enzogomes2006/esp32-deteccao-erros-telemetria/revisoes/corpo64/dados/README.md

# Série física CORPO64 - 19/10/2026

Sete pastas, uma por condição, cada uma com seis arquivos originais do coletor. Não alterar contagens nem logs manualmente. Os nomes conservam o horário local e a configuração da coleta. A série começa na sequência zero e tem mil posições por rodada.

Os CSVs foram cruzados byte a byte com os logs brutos e com o injetor. Os dados antigos de payload ficam em dados/ na raiz. Os controles curtos estão em ../triagem/ e não entram nas contagens destas sete rodadas.

Consulte ../PROVENIENCIA_COLETAS.json, ../validacao/VALIDACAO_FISICA.json e ../../../Relatorio_Final_ESP32.md. Os metadados preservam as portas observadas e os campos de verificação de firmware, sem afirmar leitura de flash.
