enzogomes2006/esp32-deteccao-erros-telemetria/LEIA_PRIMEIRO.md

# Começar pela série CORPO64

Os ensaios físicos de 19/10/2026 estão consolidados. Abra README.md para os resultados e Relatorio_Final_ESP32.pdf para o relatório atual.

Para repetir a bancada, use somente firmware e coletor em revisoes/corpo64/. O roteiro é GUIA_DEMONSTRACAO.md. As pastas firmware/, coletor/ e dados/ na raiz são da série anterior.

As pendências humanas de entrega estão em PROXIMOS_PASSOS.md. A apresentação, defesa e predição ao vivo não foram declaradas realizadas.
