enzogomes2006/esp32-deteccao-erros-telemetria/PROXIMOS_PASSOS.md

# Estado da conclusão e entrega

Atualização: 19/10/2026, série CORPO64.

## Concluído com registros

- [x] Inicialização do RX CORPO64 v1.0 e RUÍDO CORPO64 v2.0 observada durante a gravação.
- [x] Sete testes curtos de dez quadros e controles complementares sem ruído.
- [x] Sete rodadas de mil quadros e 56.000 amostras do injetor, preservadas com CSVs, logs e metadados.
- [x] Recalcular contagens, resíduos, máscaras e tempos; cruzar decisão anterior à referência e bytes do injetor.
- [x] Identificar dois erros não detectados naturais do SUM8, sequências 415 e 553.
- [x] Registrar cálculo TX, verificação RX, intervalos e controle de recuperação após pausa de recepção.
- [x] Atualizar relatório, gráficos, protocolo, roteiro de apresentação e documentos de entrada do repositório.

Os arquivos de dados e metadados originais não foram corrigidos manualmente. A revisão dos registros não certifica montagem nem calibração elétrica. Os hashes dos fontes não são leitura do firmware instalado nas placas.

## Ainda precisa ser feito pelo integrante

- [ ] Ler o relatório atualizado e conferir a identificação, os requisitos originais do professor e a declaração de assistência de IA.
- [ ] Ensaiar a explicação de TX, RX e RUÍDO, incluindo LEN inválido, sequência e auditoria posterior.
- [ ] Preparar cada integrante para prever os contadores de dez quadros e justificar a previsão antes de executar o cenário escolhido pelo professor.
- [ ] Conferir acesso ao GitHub público e levar uma cópia local do repositório/PDF para a aula.
- [ ] Entregar pelo canal indicado e realizar a demonstração/defesa presencial.

Use APRESENTACAO_20_MIN.md e GUIA_DEMONSTRACAO.md. A presença de dados e documentos não substitui a avaliação presencial nem declara conformidade com regras de autoria que não foram fornecidas integralmente.
