enzogomes2006/esp32-deteccao-erros-telemetria/latex/LEIA_LATEX.md

# Fonte LaTeX atual

main.tex contém o mesmo conteúdo do relatório Markdown CORPO64 e é regenerado por scripts/gerar_pdf.py. Compile com pdfLaTeX na pasta latex/. Os gráficos PDF ficam em revisoes/corpo64/graficos/.

O PDF publicado na raiz é diagramado com ReportLab a partir do Markdown pelo mesmo script. A compilação LaTeX é uma alternativa de layout; não há promessa de paginação idêntica. A fonte antiga foi preservada em historico/payload_2026-10-17/latex/.
