enzogomes2006/esp32-deteccao-erros-telemetria/pdfs_por_etapa/Parte_6_Validacao_do_RX_Completo_ESP32.pdf

TELEMETRIA ESP32 | EVIDÊNCIAS DO RX COMPLETO | 17/10/2026 | 1 / 5
PARTE 6 | VALIDAÇÃO DO RX COMPLETO v0.2

# Quatro ensaios curtos na bancada

Registro das capturas recebidas nesta etapa. Dez quadros por ensaio, sequência de 0 a 9, RX completo na placa identificada como COM6.

Ensaio | OK | CORROMPIDO | PERDIDO | NÃO DETECTADO | Verificação média RX (µs)
CRC8 sem ruído | 10 | 0 | 0 | 0 | 3,400
SUM8 / padrão do modo 4 | 0 | 0 | 0 | 10 | 1,000
CRC8 / padrão do modo 4 | 0 | 10 | 0 | 0 | 3,000
CRC8 / pausa da UART | 7 | 0 | 3 | 0 | 3,143

Resultado desta etapa. Os quatro ensaios apresentaram os comportamentos esperados. A rodada de recuperação tem rodada_valida=SIM confirmado na captura complementar. Nos outros três ensaios, os contadores de auditoria visíveis são zero, mas o final da linha de validação está cortado; seu indicador final não foi conferido.

O que foi observado: recepção limpa com 10 OK; alterações aceitas pelo SUM8 e depois identificadas pela auditoria; alterações descartadas pelo CRC8 antes da cópia; três perdas durante a pausa e retomada da recepção no quadro 5.

Alcance: estes testes exercitam as quatro classificações do RX completo. São ensaios complementares de dez quadros, separados das tabelas de 1000 quadros da Parte
1. As duas rodadas do modo 4 usam payloads diferentes; não representam reprodução do mesmo fluxo de bytes.

Premissa do firmware: o injetor tem como alvo o payload. O receptor usa a sequência recebida também em descartes, sob a premissa de cabeçalho sem alteração. As capturas não demonstram robustez genérica contra corrupção do cabeçalho.

Referência da implementação: rx_completo/rx_completo.ino, v0.2. Os arquivos anteriores e os resultados das Partes 1 a 5 foram preservados.

SHA256 do RX completo: aa1dec0e72c4eb6e4c8cdcc0e94e694f1ba34cb85912151970514fde71d017c3

Pendências externas a esta etapa: consolidar CSVs brutos, revisar o pareamento das condições de ruído das rodadas de 1000, atualizar a especificação e o pacote oficial para a versão escolhida, organizar repositório e demonstração. Esta validação não encerra todo o trabalho.

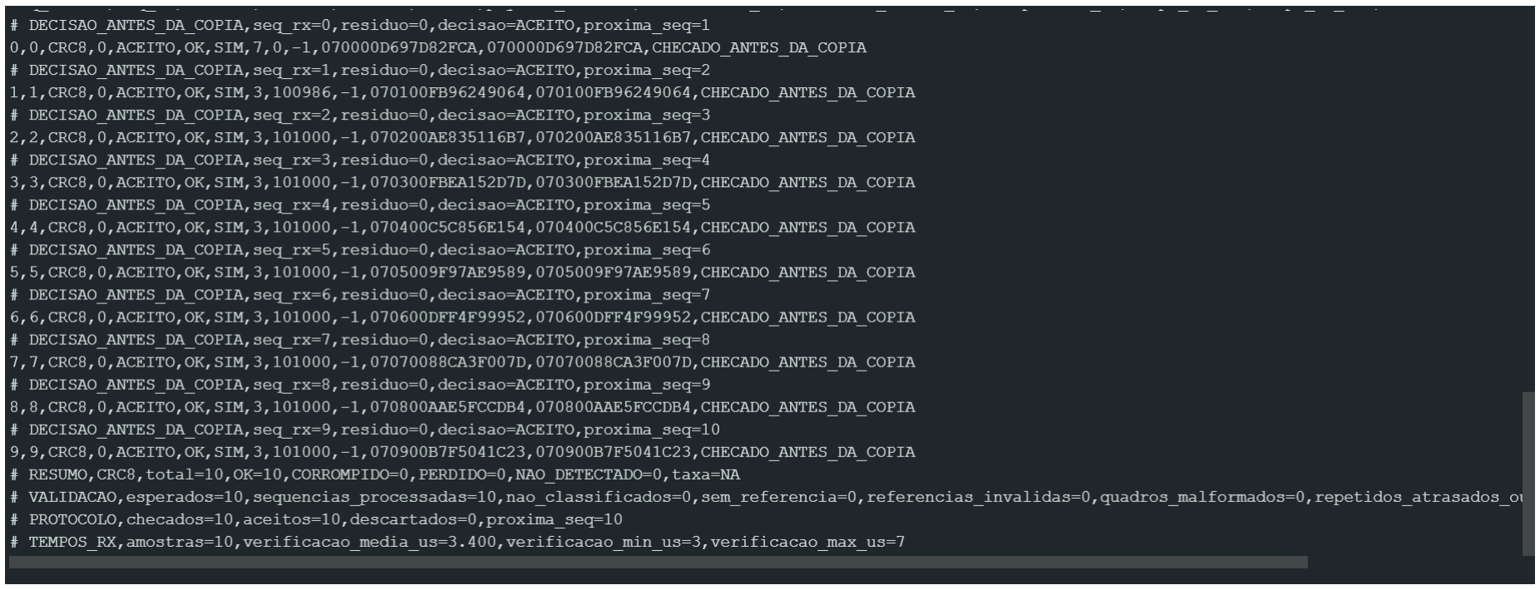
[picture p8: figure]

TELEMETRIA ESP32 | EVIDÊNCIAS DO RX COMPLETO | 17/10/2026 | 2 / 5

# 1. Controle CRC8 sem ruído

Comandos solicitados: RUÍDO 0; RX c, depois d; TX c, depois t. Cada comando enviado separadamente.

Fonte: captura enviada pelo usuário, codex-clipboard-09538eff-b445-47c5-9f80-a528c72ded37.png.
Resumo observado: total=10, OK=10, CORROMPIDO=0, PERDIDO=0, NAO_DETECTADO=0. O protocolo informa 10 checados, 10 aceitos, zero descartes e próxima sequência 10. Cada decisão visível precede a auditoria da cópia.

Tempo de verificação: 10 amostras; média 3,400 µs, mínimo 3 µs e máximo 7 µs. É a duração de checagem registrada pelo firmware, não a latência completa do enlace.

Validação visível: zero não classificados, sem referência, referências inválidas e quadros malformados. O final da linha, incluindo o indicador global, ficou fora da imagem.

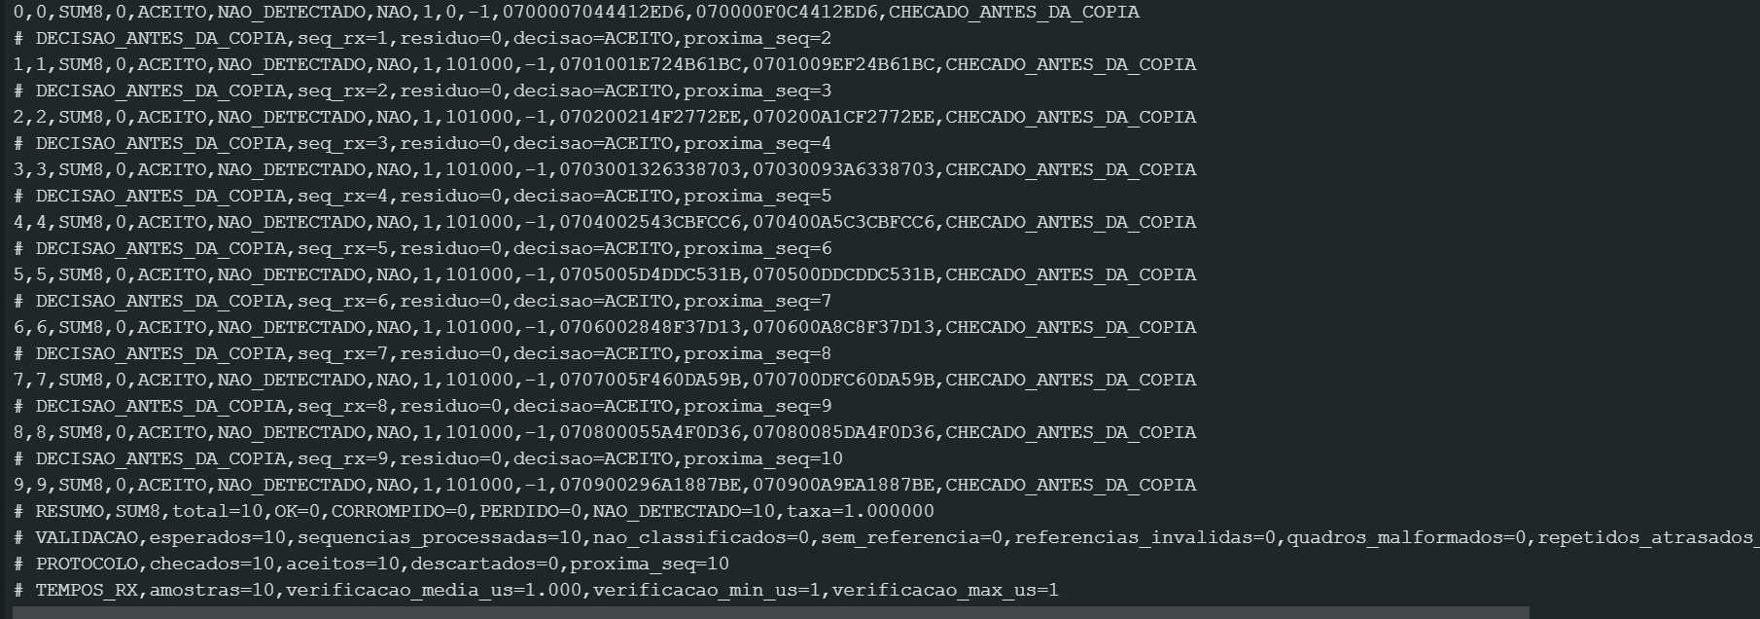
[picture p9: figure]

TELEMETRIA ESP32 | EVIDÊNCIAS DO RX COMPLETO | 17/10/2026 | 3 / 5

# 2. SUM8 aceitou o payload alterado

Comandos solicitados: RUÍDO 4; RX s, depois d; TX s, depois t. O padrão observado apaga o bit 7 de dois bytes do payload.

Fonte: captura enviada pelo usuário, codex-clipboard-51f1190f-db2d-4dd5-851a-5d915f8862e7.png.
Resumo observado: total=10, OK=0, CORROMPIDO=0, PERDIDO=0, NAO_DETECTADO=10. O enlace aceitou os dez; a auditoria posterior encontrou payloads diferentes da referência. A taxa impressa é 1,000000: 100% entre os dez quadros com erro deste ensaio específico.

Exemplo do quadro 0: original 07 00 00 F0 C4 41 2E D6; recebido 07 00 00 70 44 41 2E D6. F0 virou 70 e C4 virou 44: redução de 128 + 128 = 256. As somas incluindo CHK são 768 e 512; ambas têm resto zero módulo 256. Por isso o SUM8 aceitou o quadro alterado.

Tempo de verificação: 10 amostras, média/mínimo/máximo de 1 µs. Contadores visíveis de auditoria zerados; indicador final de validade cortado. A captura do RX comprova a alteração dos bytes, mas não substitui o log do injetor para documentar sua temporização.

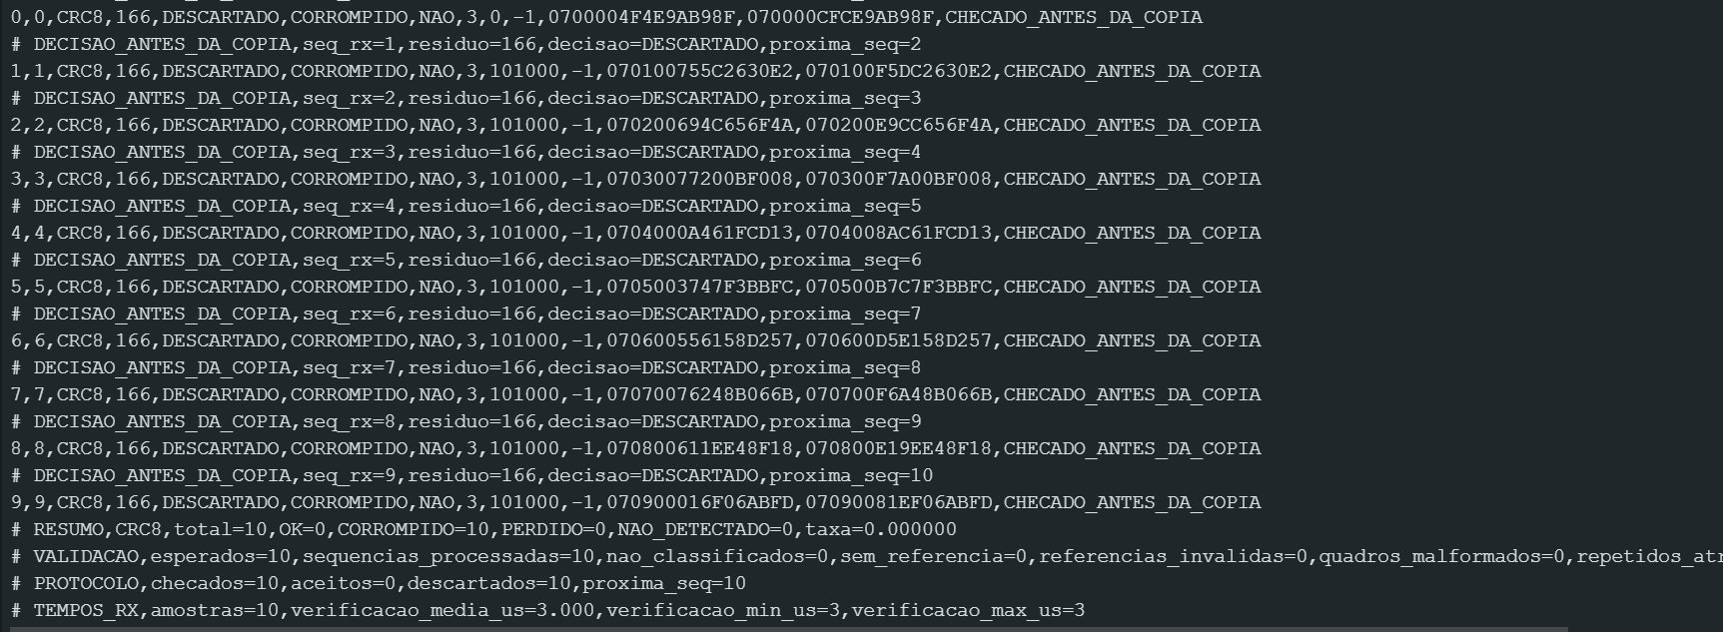
[picture p10: figure]

TELEMETRIA ESP32 | EVIDÊNCIAS DO RX COMPLETO | 17/10/2026 | 4 / 5

# 3. CRC8 descartou o mesmo padrão de erro

Comandos solicitados: manter RUÍDO 4; RX c, depois d; TX c, depois t. O padrão é o mesmo; os bytes de dados desta rodada são outros.

Fonte: captura enviada pelo usuário, codex-clipboard-03e2bd2e-41fe-4251-af52-fde8f52488ac.png.
Resumo observado: total=10, OK=0, CORROMPIDO=10, PERDIDO=0, NAO_DETECTADO=0. O protocolo informa zero aceitos, dez descartados e próxima sequência
10. Os descartes não foram somados novamente como perdas.

Exemplo do quadro 0: original 07 00 00 CF CE 9A B9 8F; recebido 07 00 00 4F 4E 9A B9 8F. Os dois bytes diferem por 0x80. O original tem resíduo CRC zero; o recebido tem resíduo 166 (0xA6), também registrado nas decisões anteriores à cópia. O recálculo local dos bytes transcritos confirma esses valores.

Tempo de verificação: 10 amostras, média/mínimo/máximo de 3 µs. Contadores visíveis de auditoria zerados; indicador final de validade cortado. Zero não detectados nestes dez quadros não é uma garantia para todo padrão possível de erro.

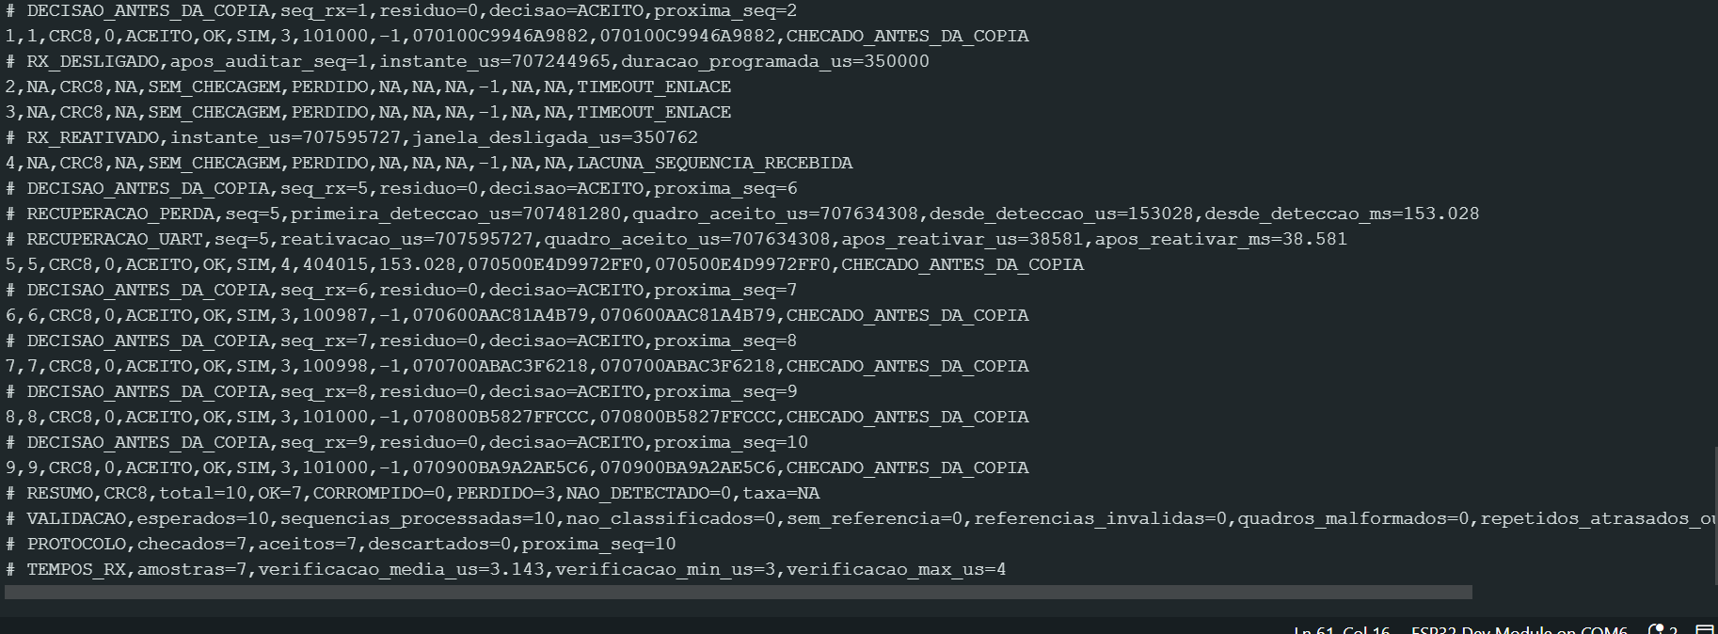
[picture p11: figure]

TELEMETRIA ESP32 | EVIDÊNCIAS DO RX COMPLETO | 17/10/2026 | 5 / 5

# 4. Perda induzida e recuperação

Comandos solicitados: RUÍDO 0; RX c, depois a; TX c, depois t. O próprio RX pausa a UART após checar e auditar a sequência 1.

Fonte: captura enviada pelo usuário, codex-clipboard-05f11e81-e1f4-49f4-b1b0-d75d64303fdd.png.

Resumo | Janela da UART desligada | Primeira perda até ACEITO | Reativação até ACEITO
7 OK; 3 PERDIDO (2, 3 e 4) | 350,762 ms | 153,028 ms | 38,581 ms

As sequências 2 e 3 foram marcadas por TIMEOUT_ENLACE; a 4, por lacuna ao receber a 5. O quadro 5 foi aceito antes da cópia, depois auditado como OK, e a recepção seguiu até o 9. Instantes em µs: UART desligada 707244965; primeira perda 707481280; UART reativada 707595727; próximo ACEITO 707634308.

Confirmação complementar: rodada_valida=SIM, repetidos_atrasados_ou_fora=0. Fonte: captura codex-clipboard-a7fccf98-29ba-4e8a-97a6-9913ed3686b8.png. As duas capturas mostram os mesmos instantes de recuperação.

Tempos RX: sete amostras, média 3,143 µs, mínimo 3 µs e máximo 4 µs. A perda foi provocada por pausa de software na UART, não por ruído elétrico. Os tempos deste RX completo não substituem as medidas do RX separado da Parte 4.
