enzogomes2006/esp32-deteccao-erros-telemetria/dados/20261019_095219_782_SUM8_modo2_1000/rx.csv

evento_id | seq_experimento | seq_rx | seq_referencia | seq_enlace_esperada | seq_enlace_proxima | tecnica | len_rx | residuo | decisao | status | payload_confere | cabecalho_diverge | entregue_aplicacao | verificacao_us | intervalo_inicio_us | recuperacao_ms | corpo_rx_hex | corpo_tx_hex | motivo | decisao_us | referencia_us
1 | 0 | 0 | 0 | 0 | 0 | SUM8 | 7 | 192 | DESCARTADO | CORROMPIDO | NAO | NAO | NAO | 1 | 0 | -1 | 070000EBFC1D288D | 070000EBFC5D288D | CHECADO_ANTES_DA_COPIA | 667833318 | 667847401
2 | 1 | 1 | 1 | 0 | 2 | SUM8 | 7 | 0 | ACEITO | OK | SIM | NAO | SIM | 1 | 101001 | -1 | 07010097D3AD4B96 | 07010097D3AD4B96 | CHECADO_ANTES_DA_COPIA | 667934318 | 667948401
3 | 2 | 2 | 2 | 2 | 2 | SUM8 | 7 | 252 | DESCARTADO | CORROMPIDO | NAO | NAO | NAO | 1 | 101000 | -1 | 070200EB9FBE2A81 | 070200EB9FBE2E81 | CHECADO_ANTES_DA_COPIA | 668035318 | 668049401
4 | 3 | 3 | 3 | 2 | 2 | SUM8 | 7 | 254 | DESCARTADO | CORROMPIDO | NAO | NAO | NAO | 1 | 101000 | -1 | 070300E3C19C2193 | 070300E3C19E2193 | CHECADO_ANTES_DA_COPIA | 668136318 | 668150401
5 | 4 | 0 | 4 | 2 | 2 | SUM8 | 7 | 252 | DESCARTADO | CORROMPIDO | SIM | SIM | NAO | 1 | 101000 | -1 | 070000C4961E205D | 070400C4961E205D | CHECADO_ANTES_DA_COPIA | 668237318 | 668251401
6 | 5 | 5 | 5 | 2 | 2 | SUM8 | 7 | 248 | DESCARTADO | CORROMPIDO | NAO | NAO | NAO | 1 | 101000 | -1 | 070500C1B4210056 | 070500C1B4290056 | CHECADO_ANTES_DA_COPIA | 668338318 | 668352401
7 | 6 | 6 | 6 | 2 | 2 | SUM8 | 3 | NA | SEM_CHECAGEM | PERDIDO | NAO | SIM | NAO | NA | 101000 | -1 | 030600A89368B798 | 070600A99368B798 | LEN_INVALIDO | 668439316 | 668453401
8 | 7 | 7 | 7 | 2 | 8 | SUM8 | 7 | 0 | ACEITO | OK | SIM | NAO | SIM | 1 | 101000 | -1 | 0707008EAD7F98A0 | 0707008EAD7F98A0 | CHECADO_ANTES_DA_COPIA | 668540318 | 668554401
9 | 8 | 8 | 8 | 8 | 9 | SUM8 | 7 | 0 | ACEITO | OK | SIM | NAO | SIM | 1 | 101000 | -1 | 07080084C2061392 | 07080084C2061392 | CHECADO_ANTES_DA_COPIA | 668641318 | 668655401
10 | 9 | 9 | 9 | 9 | 9 | SUM8 | 7 | 254 | DESCARTADO | CORROMPIDO | NAO | NAO | NAO | 1 | 101000 | -1 | 070900CD90BE458E | 070900CD90BE478E | CHECADO_ANTES_DA_COPIA | 668742318 | 668756401
11 | 10 | 10 | 10 | 9 | 9 | SUM8 | 7 | 254 | DESCARTADO | CORROMPIDO | NAO | NAO | NAO | 1 | 101000 | -1 | 070A00818D127C51 | 070A00838D127C51 | CHECADO_ANTES_DA_COPIA | 668843318 | 668857401
12 | 11 | 11 | 11 | 9 | 9 | SUM8 | 7 | 128 | DESCARTADO | CORROMPIDO | NAO | NAO | NAO | 1 | 101000 | -1 | 070B00EAD4304040 | 070B00EAD4B04040 | CHECADO_ANTES_DA_COPIA | 668944318 | 668958401
13 | 12 | 12 | 12 | 9 | 13 | SUM8 | 7 | 0 | ACEITO | OK | SIM | NAO | SIM | 1 | 101000 | -1 | 070C00DDB3BC4160 | 070C00DDB3BC4160 | CHECADO_ANTES_DA_COPIA | 669045318 | 669059401
14 | 13 | 13 | 13 | 13 | 13 | SUM8 | 5 | NA | SEM_CHECAGEM | PERDIDO | SIM | SIM | NAO | NA | 101000 | -1 | 050D00CFA431DD6B | 070D00CFA431DD6B | LEN_INVALIDO | 669146316 | 669160401
15 | 14 | 14 | 14 | 13 | 13 | SUM8 | 7 | 255 | DESCARTADO | CORROMPIDO | NAO | NAO | NAO | 1 | 101000 | -1 | 070E0096EF9C5376 | 070E0097EF9C5376 | CHECADO_ANTES_DA_COPIA | 669247318 | 669261401
16 | 15 | 15 | 15 | 13 | 16 | SUM8 | 7 | 0 | ACEITO | OK | SIM | NAO | SIM | 1 | 101000 | -1 | 070F00DE93DCF4A9 | 070F00DE93DCF4A9 | CHECADO_ANTES_DA_COPIA | 669348318 | 669362401
17 | 16 | 16 | 16 | 16 | 16 | SUM8 | 7 | 255 | DESCARTADO | CORROMPIDO | NAO | NAO | NAO | 1 | 101000 | -1 | 07100095BC15F58D | 07100095BD15F58D | CHECADO_ANTES_DA_COPIA | 669449318 | 669463401
18 | 17 | 17 | 17 | 16 | 16 | SUM8 | 7 | 160 | DESCARTADO | CORROMPIDO | SIM | NAO | NAO | 1 | 101000 | -1 | 07110085F7DAA092 | 07110085F7DAA0F2 | CHECADO_ANTES_DA_COPIA | 669550318 | 669564401
19 | 18 | 18 | 18 | 16 | 16 | SUM8 | 7 | 240 | DESCARTADO | CORROMPIDO | NAO | NAO | NAO | 1 | 101000 | -1 | 071200AECFCB2C63 | 071200AECFDB2C63 | CHECADO_ANTES_DA_COPIA | 669651318 | 669665401
20 | 19 | 19 | 19 | 16 | 16 | SUM8 | 7 | 128 | DESCARTADO | CORROMPIDO | NAO | NAO | NAO | 1 | 101000 | -1 | 071300CC48F18BD6 | 071300CCC8F18BD6 | CHECADO_ANTES_DA_COPIA | 669752318 | 669766401
21 | 20 | 20 | 20 | 16 | 21 | SUM8 | 7 | 0 | ACEITO | OK | SIM | NAO | SIM | 1 | 101000 | -1 | 071400A286636AF0 | 071400A286636AF0 | CHECADO_ANTES_DA_COPIA | 669853318 | 669867401
22 | 21 | 17 | 21 | 21 | 21 | SUM8 | 7 | 252 | DESCARTADO | CORROMPIDO | SIM | SIM | NAO | 1 | 101000 | -1 | 071100B89B85C448 | 071500B89B85C448 | CHECADO_ANTES_DA_COPIA | 669954318 | 669968401
23 | 22 | 22 | 22 | 21 | 23 | SUM8 | 7 | 0 | ACEITO | OK | SIM | NAO | SIM | 1 | 101000 | -1 | 0716009AB4642E03 | 0716009AB4642E03 | CHECADO_ANTES_DA_COPIA | 670055318 | 670069401
24 | 23 | 23 | 23 | 23 | 23 | SUM8 | 3 | NA | SEM_CHECAGEM | PERDIDO | NAO | SIM | NAO | NA | 101000 | -1 | 031700E2E986711E | 071700E2E986731E | LEN_INVALIDO | 670156316 | 670170401
25 | 24 | 24 | 24 | 23 | 23 | SUM8 | 7 | 248 | DESCARTADO | CORROMPIDO | NAO | NAO | NAO | 1 | 101000 | -1 | 071800E0841D2236 | 071800E0841D2A36 | CHECADO_ANTES_DA_COPIA | 670257318 | 670271401
26 | 25 | 25 | 25 | 23 | 26 | SUM8 | 7 | 0 | ACEITO | OK | SIM | NAO | SIM | 1 | 101000 | -1 | 07190090D28AFEF6 | 07190090D28AFEF6 | CHECADO_ANTES_DA_COPIA | 670358318 | 670372401
27 | 26 | 18 | 26 | 26 | 26 | SUM8 | 7 | 248 | DESCARTADO | CORROMPIDO | SIM | SIM | NAO | 1 | 101000 | -1 | 0712009EFABB107C | 071A009EFABB107C | CHECADO_ANTES_DA_COPIA | 670459318 | 670473401
28 | 27 | 27 | 27 | 26 | 28 | SUM8 | 7 | 0 | ACEITO | OK | SIM | NAO | SIM | 1 | 101000 | -1 | 071B00B2A7752FE1 | 071B00B2A7752FE1 | CHECADO_ANTES_DA_COPIA | 670560318 | 670574401
29 | 28 | 20 | 28 | 28 | 28 | SUM8 | 7 | 248 | DESCARTADO | CORROMPIDO | SIM | SIM | NAO | 1 | 101000 | -1 | 071400C1EED08ED0 | 071C00C1EED08ED0 | CHECADO_ANTES_DA_COPIA | 670661318 | 670675401
30 | 29 | 21 | 29 | 28 | 28 | SUM8 | 7 | 248 | DESCARTADO | CORROMPIDO | SIM | SIM | NAO | 1 | 101000 | -1 | 071500E2F3631B89 | 071D00E2F3631B89 | CHECADO_ANTES_DA_COPIA | 670762318 | 670776401
31 | 30 | 30 | 30 | 28 | 28 | SUM8 | 7 | 128 | DESCARTADO | CORROMPIDO | NAO | NAO | NAO | 1 | 101000 | -1 | 071E008BA51342D6 | 071E008BA513C2D6 | CHECADO_ANTES_DA_COPIA | 670863318 | 670877401
32 | 31 | 31 | 31 | 28 | 28 | SUM8 | 7 | 254 | DESCARTADO | CORROMPIDO | NAO | NAO | NAO | 1 | 101000 | -1 | 071F00E4BB11B771 | 071F00E4BB13B771 | CHECADO_ANTES_DA_COPIA | 670964318 | 670978401
33 | 32 | 32 | 32 | 28 | 33 | SUM8 | 7 | 0 | ACEITO | OK | SIM | NAO | SIM | 1 | 101000 | -1 | 0720008FC75F64C0 | 0720008FC75F64C0 | CHECADO_ANTES_DA_COPIA | 671065318 | 671079401
34 | 33 | 33 | 33 | 33 | 34 | SUM8 | 7 | 0 | ACEITO | OK | SIM | NAO | SIM | 1 | 101000 | -1 | 07210088F37D617F | 07210088F37D617F | CHECADO_ANTES_DA_COPIA | 671166318 | 671180401
35 | 34 | 34 | 34 | 34 | 34 | SUM8 | 3 | NA | SEM_CHECAGEM | PERDIDO | SIM | SIM | NAO | NA | 101000 | -1 | 032200FDDBE12FEF | 072200FDDBE12FEF | LEN_INVALIDO | 671267316 | 671281401
36 | 35 | 35 | 35 | 34 | 34 | SUM8 | 7 | 192 | DESCARTADO | CORROMPIDO | NAO | NAO | NAO | 1 | 101000 | -1 | 072300AC8653BF52 | 072300AC8653FF52 | CHECADO_ANTES_DA_COPIA | 671368318 | 671382401
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
615 | 614 | 610 | 614 | 611 | 611 | SUM8 | 7 | 252 | DESCARTADO | CORROMPIDO | SIM | SIM | NAO | 1 | 101000 | -1 | 076202EBD8CAFA0A | 076602EBD8CAFA0A | CHECADO_ANTES_DA_COPIA | 729848318 | 729861560
616 | 615 | 615 | 615 | 611 | 611 | SUM8 | 7 | 240 | DESCARTADO | CORROMPIDO | NAO | NAO | NAO | 1 | 101000 | -1 | 076702AE9E3E8C6A | 076702AE9E3E9C6A | CHECADO_ANTES_DA_COPIA | 729949318 | 729962560
617 | 616 | 608 | 616 | 611 | 611 | SUM8 | 7 | 248 | DESCARTADO | CORROMPIDO | SIM | SIM | NAO | 1 | 101000 | -1 | 076002BDBC41676E | 076802BDBC41676E | CHECADO_ANTES_DA_COPIA | 730050318 | 730063562
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
