enzogomes2006/esp32-deteccao-erros-telemetria/revisoes/corpo64/triagem/20261019_085335_636_SUM8_modo0_10/rx.csv

evento_id | seq_experimento | seq_rx | seq_referencia | seq_enlace_esperada | seq_enlace_proxima | tecnica | len_rx | residuo | decisao | status | payload_confere | cabecalho_diverge | entregue_aplicacao | verificacao_us | intervalo_inicio_us | recuperacao_ms | corpo_rx_hex | corpo_tx_hex | motivo | decisao_us | referencia_us
1 | 0 | 0 | 0 | 0 | 1 | SUM8 | 7 | 0 | ACEITO | OK | SIM | NAO | SIM | 7 | 0 | -1 | 070000E3C6FDCA89 | 070000E3C6FDCA89 | CHECADO_ANTES_DA_COPIA | 924283356 | 924297395
2 | 1 | 1 | 1 | 1 | 2 | SUM8 | 7 | 0 | ACEITO | OK | SIM | NAO | SIM | 1 | 100987 | -1 | 070100C7AED8D9D2 | 070100C7AED8D9D2 | CHECADO_ANTES_DA_COPIA | 924384331 | 924398393
3 | 2 | 2 | 2 | 2 | 3 | SUM8 | 7 | 0 | ACEITO | OK | SIM | NAO | SIM | 1 | 101000 | -1 | 070200ADF2B4851F | 070200ADF2B4851F | CHECADO_ANTES_DA_COPIA | 924485331 | 924499393
4 | 3 | 3 | 3 | 3 | 4 | SUM8 | 7 | 0 | ACEITO | OK | SIM | NAO | SIM | 1 | 101000 | -1 | 070300A8F591B513 | 070300A8F591B513 | CHECADO_ANTES_DA_COPIA | 924586331 | 924600393
5 | 4 | 4 | 4 | 4 | 5 | SUM8 | 7 | 0 | ACEITO | OK | SIM | NAO | SIM | 1 | 101000 | -1 | 070400C2D4DAC5C0 | 070400C2D4DAC5C0 | CHECADO_ANTES_DA_COPIA | 924687331 | 924701393
6 | 5 | 5 | 5 | 5 | 6 | SUM8 | 7 | 0 | ACEITO | OK | SIM | NAO | SIM | 1 | 101000 | -1 | 0705008FDC51B97F | 0705008FDC51B97F | CHECADO_ANTES_DA_COPIA | 924788331 | 924802393
7 | 6 | 6 | 6 | 6 | 7 | SUM8 | 7 | 0 | ACEITO | OK | SIM | NAO | SIM | 1 | 101000 | -1 | 070600E4E09C6C27 | 070600E4E09C6C27 | CHECADO_ANTES_DA_COPIA | 924889331 | 924903393
8 | 7 | 7 | 7 | 7 | 8 | SUM8 | 7 | 0 | ACEITO | OK | SIM | NAO | SIM | 1 | 101000 | -1 | 070700C9FFD45FF7 | 070700C9FFD45FF7 | CHECADO_ANTES_DA_COPIA | 924990331 | 925004393
9 | 8 | 8 | 8 | 8 | 9 | SUM8 | 7 | 0 | ACEITO | OK | SIM | NAO | SIM | 1 | 101000 | -1 | 0708009EBEDCD4E5 | 0708009EBEDCD4E5 | CHECADO_ANTES_DA_COPIA | 925091331 | 925105393
10 | 9 | 9 | 9 | 9 | 10 | SUM8 | 7 | 0 | ACEITO | OK | SIM | NAO | SIM | 1 | 101000 | -1 | 070900ED97C28921 | 070900ED97C28921 | CHECADO_ANTES_DA_COPIA | 925192331 | 925206393
