enzogomes2006/esp32-deteccao-erros-telemetria/revisoes/corpo64/triagem/20261019_085556_983_SUM8_modo1_10/rx.csv

evento_id | seq_experimento | seq_rx | seq_referencia | seq_enlace_esperada | seq_enlace_proxima | tecnica | len_rx | residuo | decisao | status | payload_confere | cabecalho_diverge | entregue_aplicacao | verificacao_us | intervalo_inicio_us | recuperacao_ms | corpo_rx_hex | corpo_tx_hex | motivo | decisao_us | referencia_us
1 | 0 | 0 | 0 | 0 | 1 | SUM8 | 7 | 0 | ACEITO | OK | SIM | NAO | SIM | 1 | 0 | -1 | 070000B899BF6485 | 070000B899BF6485 | CHECADO_ANTES_DA_COPIA | 1062177331 | 1062191371
2 | 1 | 1 | 1 | 1 | 2 | SUM8 | 7 | 0 | ACEITO | OK | SIM | NAO | SIM | 1 | 101001 | -1 | 070100E1C0F381E3 | 070100E1C0F381E3 | CHECADO_ANTES_DA_COPIA | 1062278331 | 1062292371
3 | 2 | 2 | 2 | 2 | 3 | SUM8 | 7 | 0 | ACEITO | OK | SIM | NAO | SIM | 1 | 101000 | -1 | 07020080CBF5F2C5 | 07020080CBF5F2C5 | CHECADO_ANTES_DA_COPIA | 1062379331 | 1062393371
4 | 3 | 3 | 3 | 3 | 4 | SUM8 | 7 | 0 | ACEITO | OK | SIM | NAO | SIM | 1 | 101000 | -1 | 070300E3DC0573BF | 070300E3DC0573BF | CHECADO_ANTES_DA_COPIA | 1062480331 | 1062494371
5 | 4 | 4 | 4 | 4 | 5 | SUM8 | 7 | 0 | ACEITO | OK | SIM | NAO | SIM | 1 | 101000 | -1 | 070400F8C00248F3 | 070400F8C00248F3 | CHECADO_ANTES_DA_COPIA | 1062581331 | 1062595371
6 | 5 | 5 | 5 | 5 | 6 | SUM8 | 7 | 0 | ACEITO | OK | SIM | NAO | SIM | 1 | 101000 | -1 | 070500F4B7C10781 | 070500F4B7C10781 | CHECADO_ANTES_DA_COPIA | 1062682331 | 1062696371
7 | 6 | 6 | 6 | 6 | 7 | SUM8 | 7 | 0 | ACEITO | OK | SIM | NAO | SIM | 1 | 101000 | -1 | 070600D1F7278381 | 070600D1F7278381 | CHECADO_ANTES_DA_COPIA | 1062783331 | 1062797371
8 | 7 | 7 | 7 | 7 | 7 | SUM8 | 7 | 248 | DESCARTADO | CORROMPIDO | NAO | NAO | NAO | 1 | 101000 | -1 | 070700E6A946C64F | 070700EEA946C64F | CHECADO_ANTES_DA_COPIA | 1062884331 | 1062898371
9 | 8 | 8 | 8 | 7 | 9 | SUM8 | 7 | 0 | ACEITO | OK | SIM | NAO | SIM | 1 | 101000 | -1 | 07080093ADDDFBD9 | 07080093ADDDFBD9 | CHECADO_ANTES_DA_COPIA | 1062985331 | 1062999371
10 | 9 | 9 | 9 | 9 | 10 | SUM8 | 7 | 0 | ACEITO | OK | SIM | NAO | SIM | 1 | 101000 | -1 | 070900D4EAA1D5BC | 070900D4EAA1D5BC | CHECADO_ANTES_DA_COPIA | 1063086331 | 1063100371
