enzogomes2006/esp32-deteccao-erros-telemetria/revisoes/corpo64/triagem/20261019_085705_555_SUM8_modo2_10/rx.csv

evento_id | seq_experimento | seq_rx | seq_referencia | seq_enlace_esperada | seq_enlace_proxima | tecnica | len_rx | residuo | decisao | status | payload_confere | cabecalho_diverge | entregue_aplicacao | verificacao_us | intervalo_inicio_us | recuperacao_ms | corpo_rx_hex | corpo_tx_hex | motivo | decisao_us | referencia_us
1 | 0 | 0 | 0 | 0 | 1 | SUM8 | 7 | 0 | ACEITO | OK | SIM | NAO | SIM | 1 | 0 | -1 | 070000C2D3421111 | 070000C2D3421111 | CHECADO_ANTES_DA_COPIA | 1130536331 | 1130550544
2 | 1 | 1 | 1 | 1 | 2 | SUM8 | 7 | 0 | ACEITO | OK | SIM | NAO | SIM | 1 | 101000 | -1 | 070100F5F0D1FB47 | 070100F5F0D1FB47 | CHECADO_ANTES_DA_COPIA | 1130637331 | 1130651544
3 | 2 | 2 | 2 | 2 | 3 | SUM8 | 7 | 0 | ACEITO | OK | SIM | NAO | SIM | 1 | 101000 | -1 | 0702009C9F05B205 | 0702009C9F05B205 | CHECADO_ANTES_DA_COPIA | 1130738331 | 1130752544
4 | 3 | 3 | 3 | 3 | 4 | SUM8 | 7 | 0 | ACEITO | OK | SIM | NAO | SIM | 1 | 101000 | -1 | 070300C9EC834E70 | 070300C9EC834E70 | CHECADO_ANTES_DA_COPIA | 1130839331 | 1130853544
5 | 4 | 4 | 4 | 4 | 4 | SUM8 | 7 | 252 | DESCARTADO | CORROMPIDO | NAO | NAO | NAO | 1 | 101000 | -1 | 070400BFE2FF272A | 070400BFE6FF272A | CHECADO_ANTES_DA_COPIA | 1130940331 | 1130954544
6 | 5 | 5 | 5 | 4 | 6 | SUM8 | 7 | 0 | ACEITO | OK | SIM | NAO | SIM | 1 | 101000 | -1 | 070500ED9A6F9C62 | 070500ED9A6F9C62 | CHECADO_ANTES_DA_COPIA | 1131041331 | 1131055544
7 | 6 | 2 | 6 | 6 | 6 | SUM8 | 5 | NA | SEM_CHECAGEM | PERDIDO | SIM | SIM | NAO | NA | 101000 | -1 | 050200A3E56EE617 | 070600A3E56EE617 | LEN_INVALIDO | 1131142329 | 1131156544
8 | 7 | 7 | 7 | 6 | 8 | SUM8 | 7 | 0 | ACEITO | OK | SIM | NAO | SIM | 1 | 101000 | -1 | 070700D9C9C67416 | 070700D9C9C67416 | CHECADO_ANTES_DA_COPIA | 1131243331 | 1131257544
9 | 8 | 8 | 8 | 8 | 8 | SUM8 | 7 | 252 | DESCARTADO | CORROMPIDO | NAO | NAO | NAO | 1 | 101000 | -1 | 070800ECA2E982F4 | 070800ECA6E982F4 | CHECADO_ANTES_DA_COPIA | 1131344331 | 1131358544
10 | 9 | 9 | 9 | 8 | 8 | SUM8 | 7 | 216 | DESCARTADO | CORROMPIDO | NAO | NAO | NAO | 1 | 101000 | -1 | 07090093E9E3D099 | 0709009BE9E3F099 | CHECADO_ANTES_DA_COPIA | 1131445331 | 1131459544
