enzogomes2006/esp32-deteccao-erros-telemetria/revisoes/corpo64/triagem/20261019_085757_703_SUM8_modo3_10/rx.csv

evento_id | seq_experimento | seq_rx | seq_referencia | seq_enlace_esperada | seq_enlace_proxima | tecnica | len_rx | residuo | decisao | status | payload_confere | cabecalho_diverge | entregue_aplicacao | verificacao_us | intervalo_inicio_us | recuperacao_ms | corpo_rx_hex | corpo_tx_hex | motivo | decisao_us | referencia_us
1 | 0 | 0 | 0 | 0 | 0 | SUM8 | 7 | 192 | DESCARTADO | CORROMPIDO | NAO | NAO | NAO | 1 | 0 | -1 | 070000F6C5BC80C2 | 070000F6C5BCC0C2 | CHECADO_ANTES_DA_COPIA | 1191760331 | 1191774328
2 | 1 | 1 | 1 | 0 | 0 | SUM8 | 7 | 224 | DESCARTADO | CORROMPIDO | NAO | NAO | NAO | 1 | 101001 | -1 | 070100A3C2BD4076 | 070100A3C2BD6076 | CHECADO_ANTES_DA_COPIA | 1191861331 | 1191875328
3 | 2 | 2 | 2 | 0 | 0 | SUM8 | 7 | 253 | DESCARTADO | CORROMPIDO | NAO | NAO | NAO | 1 | 101000 | -1 | 070200ACB4400B49 | 070200ACB4430B49 | CHECADO_ANTES_DA_COPIA | 1191962331 | 1191976328
4 | 3 | 3 | 3 | 0 | 0 | SUM8 | 7 | 146 | DESCARTADO | CORROMPIDO | NAO | NAO | NAO | 1 | 101000 | -1 | 070300B1A06F8048 | 070300B1A06FEE48 | CHECADO_ANTES_DA_COPIA | 1192063331 | 1192077328
5 | 4 | 4 | 4 | 0 | 5 | SUM8 | 7 | 0 | ACEITO | OK | SIM | NAO | SIM | 1 | 101000 | -1 | 070400B6D047D454 | 070400B6D047D454 | CHECADO_ANTES_DA_COPIA | 1192164331 | 1192178328
6 | 5 | 5 | 5 | 5 | 6 | SUM8 | 7 | 0 | ACEITO | OK | SIM | NAO | SIM | 1 | 101000 | -1 | 070500DBBB9A3F85 | 070500DBBB9A3F85 | CHECADO_ANTES_DA_COPIA | 1192265331 | 1192279328
7 | 6 | 6 | 6 | 6 | 6 | SUM8 | 7 | 72 | DESCARTADO | CORROMPIDO | NAO | NAO | NAO | 1 | 101000 | -1 | 070600E400BA3F5E | 070600E4B8BA3F5E | CHECADO_ANTES_DA_COPIA | 1192366331 | 1192380328
8 | 7 | 7 | 7 | 6 | 6 | SUM8 | 7 | 228 | DESCARTADO | CORROMPIDO | SIM | NAO | NAO | 1 | 101000 | -1 | 070700B1D58B25A0 | 070700B1D58B25BC | CHECADO_ANTES_DA_COPIA | 1192467331 | 1192481328
9 | 8 | 8 | 8 | 6 | 6 | SUM8 | 7 | 128 | DESCARTADO | CORROMPIDO | SIM | NAO | NAO | 1 | 101000 | -1 | 07080088D3050A07 | 07080088D3050A87 | CHECADO_ANTES_DA_COPIA | 1192568331 | 1192582328
10 | 9 | 1 | 9 | 6 | 6 | SUM8 | 7 | 248 | DESCARTADO | CORROMPIDO | SIM | SIM | NAO | 1 | 101000 | -1 | 070100FA99AB971B | 070900FA99AB971B | CHECADO_ANTES_DA_COPIA | 1192669331 | 1192683328
