enzogomes2006/esp32-deteccao-erros-telemetria/revisoes/corpo64/triagem/20261019_085918_397_CRC8_modo1_10/rx.csv

evento_id | seq_experimento | seq_rx | seq_referencia | seq_enlace_esperada | seq_enlace_proxima | tecnica | len_rx | residuo | decisao | status | payload_confere | cabecalho_diverge | entregue_aplicacao | verificacao_us | intervalo_inicio_us | recuperacao_ms | corpo_rx_hex | corpo_tx_hex | motivo | decisao_us | referencia_us
1 | 0 | 0 | 0 | 0 | 1 | CRC8 | 7 | 0 | ACEITO | OK | SIM | NAO | SIM | 5 | 0 | -1 | 070000BDCB2D20B3 | 070000BDCB2D20B3 | CHECADO_ANTES_DA_COPIA | 1264656335 | 1264670501
2 | 1 | 1 | 1 | 1 | 1 | CRC8 | 7 | 42 | DESCARTADO | CORROMPIDO | NAO | NAO | NAO | 3 | 101000 | -1 | 070100FC9BE3A08F | 070100FC9BE3A28F | CHECADO_ANTES_DA_COPIA | 1264757333 | 1264771501
3 | 2 | 2 | 2 | 1 | 3 | CRC8 | 7 | 0 | ACEITO | OK | SIM | NAO | SIM | 3 | 101000 | -1 | 070200CDC2127B55 | 070200CDC2127B55 | CHECADO_ANTES_DA_COPIA | 1264858334 | 1264872501
4 | 3 | 3 | 3 | 3 | 4 | CRC8 | 7 | 0 | ACEITO | OK | SIM | NAO | SIM | 3 | 101000 | -1 | 070300BCD388BEA7 | 070300BCD388BEA7 | CHECADO_ANTES_DA_COPIA | 1264959334 | 1264973501
5 | 4 | 4 | 4 | 4 | 5 | CRC8 | 7 | 0 | ACEITO | OK | SIM | NAO | SIM | 3 | 101000 | -1 | 070400869C4512C5 | 070400869C4512C5 | CHECADO_ANTES_DA_COPIA | 1265060334 | 1265074522
6 | 5 | 5 | 5 | 5 | 6 | CRC8 | 7 | 0 | ACEITO | OK | SIM | NAO | SIM | 3 | 101000 | -1 | 070500E0FA655F3F | 070500E0FA655F3F | CHECADO_ANTES_DA_COPIA | 1265161334 | 1265175522
7 | 6 | 6 | 6 | 6 | 6 | CRC8 | 7 | 22 | DESCARTADO | CORROMPIDO | NAO | NAO | NAO | 3 | 101000 | -1 | 070600B792954854 | 070600B793954854 | CHECADO_ANTES_DA_COPIA | 1265262333 | 1265276522
8 | 7 | 7 | 7 | 6 | 6 | CRC8 | 7 | 44 | DESCARTADO | CORROMPIDO | NAO | NAO | NAO | 3 | 101000 | -1 | 0707009398ABE2A1 | 070700939AABE2A1 | CHECADO_ANTES_DA_COPIA | 1265363333 | 1265377522
9 | 8 | 8 | 8 | 6 | 9 | CRC8 | 7 | 0 | ACEITO | OK | SIM | NAO | SIM | 3 | 101000 | -1 | 070800C8A1E9D0A5 | 070800C8A1E9D0A5 | CHECADO_ANTES_DA_COPIA | 1265464334 | 1265478522
10 | 9 | 9 | 9 | 9 | 10 | CRC8 | 7 | 0 | ACEITO | OK | SIM | NAO | SIM | 3 | 101000 | -1 | 070900B4C9DC289C | 070900B4C9DC289C | CHECADO_ANTES_DA_COPIA | 1265565334 | 1265579522
