enzogomes2006/esp32-deteccao-erros-telemetria/revisoes/corpo64/triagem/20261019_090046_797_CRC8_modo2_10/rx.csv

evento_id | seq_experimento | seq_rx | seq_referencia | seq_enlace_esperada | seq_enlace_proxima | tecnica | len_rx | residuo | decisao | status | payload_confere | cabecalho_diverge | entregue_aplicacao | verificacao_us | intervalo_inicio_us | recuperacao_ms | corpo_rx_hex | corpo_tx_hex | motivo | decisao_us | referencia_us
1 | 0 | 0 | 0 | 0 | 1 | CRC8 | 7 | 0 | ACEITO | OK | SIM | NAO | SIM | 3 | 0 | -1 | 070000D8AC4EE1F8 | 070000D8AC4EE1F8 | CHECADO_ANTES_DA_COPIA | 1351463334 | 1351477371
2 | 1 | 1 | 1 | 1 | 1 | CRC8 | 7 | 103 | DESCARTADO | CORROMPIDO | NAO | NAO | NAO | 3 | 101001 | -1 | 070100F387F95E88 | 070100F397F95E88 | CHECADO_ANTES_DA_COPIA | 1351564333 | 1351578371
3 | 2 | 2 | 2 | 1 | 1 | CRC8 | 7 | 214 | DESCARTADO | CORROMPIDO | NAO | NAO | NAO | 3 | 101000 | -1 | 070200F494D82EEA | 070200F494DA2EEA | CHECADO_ANTES_DA_COPIA | 1351665333 | 1351679371
4 | 3 | 3 | 3 | 1 | 4 | CRC8 | 7 | 0 | ACEITO | OK | SIM | NAO | SIM | 3 | 101000 | -1 | 070300F1E78C8A50 | 070300F1E78C8A50 | CHECADO_ANTES_DA_COPIA | 1351766334 | 1351780371
5 | 4 | 4 | 4 | 4 | 5 | CRC8 | 7 | 0 | ACEITO | OK | SIM | NAO | SIM | 3 | 101000 | -1 | 070400C6E930B07D | 070400C6E930B07D | CHECADO_ANTES_DA_COPIA | 1351867334 | 1351881371
6 | 5 | 5 | 5 | 5 | 5 | CRC8 | 7 | 176 | DESCARTADO | CORROMPIDO | NAO | NAO | NAO | 3 | 101000 | -1 | 0705008FE42820AF | 0705008FEC2820AF | CHECADO_ANTES_DA_COPIA | 1351968333 | 1351982371
7 | 6 | 6 | 6 | 5 | 5 | CRC8 | 7 | 214 | DESCARTADO | CORROMPIDO | NAO | NAO | NAO | 3 | 101000 | -1 | 0706009BD96D3DA9 | 0706009BD96F3DA9 | CHECADO_ANTES_DA_COPIA | 1352069333 | 1352083371
8 | 7 | 5 | 7 | 5 | 5 | CRC8 | 7 | 185 | DESCARTADO | CORROMPIDO | SIM | SIM | NAO | 3 | 101000 | -1 | 070500E8CFE0048D | 070700E8CFE0048D | CHECADO_ANTES_DA_COPIA | 1352170333 | 1352184371
9 | 8 | 8 | 8 | 5 | 9 | CRC8 | 7 | 0 | ACEITO | OK | SIM | NAO | SIM | 3 | 101000 | -1 | 07080082D04AF267 | 07080082D04AF267 | CHECADO_ANTES_DA_COPIA | 1352271334 | 1352285371
10 | 9 | 9 | 9 | 9 | 9 | CRC8 | 7 | 7 | DESCARTADO | CORROMPIDO | SIM | NAO | NAO | 3 | 101000 | -1 | 0709008ED47B538E | 0709008ED47B538F | CHECADO_ANTES_DA_COPIA | 1352372333 | 1352386371
