enzogomes2006/esp32-deteccao-erros-telemetria/revisoes/corpo64/triagem/20261019_090207_975_CRC8_modo3_10/rx.csv

evento_id | seq_experimento | seq_rx | seq_referencia | seq_enlace_esperada | seq_enlace_proxima | tecnica | len_rx | residuo | decisao | status | payload_confere | cabecalho_diverge | entregue_aplicacao | verificacao_us | intervalo_inicio_us | recuperacao_ms | corpo_rx_hex | corpo_tx_hex | motivo | decisao_us | referencia_us
1 | 0 | 0 | 0 | 0 | 1 | CRC8 | 7 | 0 | ACEITO | OK | SIM | NAO | SIM | 3 | 0 | -1 | 07000091E530D78F | 07000091E530D78F | CHECADO_ANTES_DA_COPIA | 1433182334 | 1433195576
2 | 1 | 1 | 1 | 1 | 1 | CRC8 | 7 | 242 | DESCARTADO | CORROMPIDO | NAO | NAO | NAO | 3 | 101001 | -1 | 070100E6FBC3005E | 070100E6FBC3B95E | CHECADO_ANTES_DA_COPIA | 1433283333 | 1433296576
3 | 2 | 2 | 2 | 1 | 1 | CRC8 | 7 | 76 | DESCARTADO | CORROMPIDO | NAO | NAO | NAO | 3 | 101000 | -1 | 07020091CA10012E | 07020091CA10A52E | CHECADO_ANTES_DA_COPIA | 1433384333 | 1433397576
4 | 3 | 3 | 3 | 1 | 1 | CRC8 | 7 | 202 | DESCARTADO | CORROMPIDO | SIM | NAO | NAO | 3 | 101000 | -1 | 070300DBF67B4DC1 | 070300DBF67B4DEF | CHECADO_ANTES_DA_COPIA | 1433485333 | 1433498576
5 | 4 | 4 | 4 | 1 | 1 | CRC8 | 7 | 173 | DESCARTADO | CORROMPIDO | NAO | NAO | NAO | 3 | 101000 | -1 | 07040000AE456777 | 070400ECAE456777 | CHECADO_ANTES_DA_COPIA | 1433586333 | 1433599576
6 | 5 | 5 | 5 | 1 | 1 | CRC8 | 7 | 243 | DESCARTADO | CORROMPIDO | NAO | NAO | NAO | 3 | 101000 | -1 | 070500F2D5FB0022 | 070500F2D5FB4822 | CHECADO_ANTES_DA_COPIA | 1433687333 | 1433700576
7 | 6 | 6 | 6 | 1 | 7 | CRC8 | 7 | 0 | ACEITO | OK | SIM | NAO | SIM | 3 | 101000 | -1 | 07060097D266E10A | 07060097D266E10A | CHECADO_ANTES_DA_COPIA | 1433788334 | 1433801576
8 | 7 | 7 | 7 | 7 | 7 | CRC8 | 7 | 44 | DESCARTADO | CORROMPIDO | NAO | NAO | NAO | 3 | 101000 | -1 | 0707009AE0182A37 | 0707009AE2182A37 | CHECADO_ANTES_DA_COPIA | 1433889333 | 1433902576
9 | 8 | 8 | 8 | 7 | 7 | CRC8 | 7 | 143 | DESCARTADO | CORROMPIDO | NAO | NAO | NAO | 3 | 101000 | -1 | 07080082FDCAE439 | 07080086FDCAE439 | CHECADO_ANTES_DA_COPIA | 1433990333 | 1434003575
10 | 9 | 9 | 9 | 7 | 10 | CRC8 | 7 | 0 | ACEITO | OK | SIM | NAO | SIM | 3 | 101000 | -1 | 0709009C98BE8E09 | 0709009C98BE8E09 | CHECADO_ANTES_DA_COPIA | 1434091334 | 1434104576
