enzogomes2006/esp32-deteccao-erros-telemetria/revisoes/corpo64/triagem/20261019_102158_177_SUM8_modo0_10/rx.csv

evento_id | seq_experimento | seq_rx | seq_referencia | seq_enlace_esperada | seq_enlace_proxima | tecnica | len_rx | residuo | decisao | status | payload_confere | cabecalho_diverge | entregue_aplicacao | verificacao_us | intervalo_inicio_us | recuperacao_ms | corpo_rx_hex | corpo_tx_hex | motivo | decisao_us | referencia_us
1 | 0 | 0 | 0 | 0 | 1 | SUM8 | 7 | 0 | ACEITO | OK | SIM | NAO | SIM | 1 | 0 | -1 | 07000083D79A0BFA | 07000083D79A0BFA | CHECADO_ANTES_DA_COPIA | 2447544318 | 2447557580
2 | 1 | 1 | 1 | 1 | 2 | SUM8 | 7 | 0 | ACEITO | OK | SIM | NAO | SIM | 1 | 101001 | -1 | 070100F8FC344C84 | 070100F8FC344C84 | CHECADO_ANTES_DA_COPIA | 2447645318 | 2447658580
3 | 2 | 2 | 2 | 2 | 3 | SUM8 | 7 | 0 | ACEITO | OK | SIM | NAO | SIM | 1 | 101000 | -1 | 070200FBDBB96FF9 | 070200FBDBB96FF9 | CHECADO_ANTES_DA_COPIA | 2447746318 | 2447759580
4 | 3 | 3 | 3 | 3 | 4 | SUM8 | 7 | 0 | ACEITO | OK | SIM | NAO | SIM | 1 | 101000 | -1 | 070300CAE6ED4F0A | 070300CAE6ED4F0A | CHECADO_ANTES_DA_COPIA | 2447847318 | 2447860580
5 | 4 | 4 | 4 | 4 | 5 | SUM8 | 7 | 0 | ACEITO | OK | SIM | NAO | SIM | 1 | 101000 | -1 | 070400C0B1501F15 | 070400C0B1501F15 | CHECADO_ANTES_DA_COPIA | 2447948318 | 2447961580
6 | 5 | 5 | 5 | 5 | 6 | SUM8 | 7 | 0 | ACEITO | OK | SIM | NAO | SIM | 1 | 101000 | -1 | 070500F5E4B41D4A | 070500F5E4B41D4A | CHECADO_ANTES_DA_COPIA | 2448049318 | 2448062579
7 | 6 | 6 | 6 | 6 | 7 | SUM8 | 7 | 0 | ACEITO | OK | SIM | NAO | SIM | 1 | 101000 | -1 | 070600EBC7C2730C | 070600EBC7C2730C | CHECADO_ANTES_DA_COPIA | 2448150318 | 2448163579
8 | 7 | 7 | 7 | 7 | 8 | SUM8 | 7 | 0 | ACEITO | OK | SIM | NAO | SIM | 1 | 101000 | -1 | 070700B8E3605F98 | 070700B8E3605F98 | CHECADO_ANTES_DA_COPIA | 2448251318 | 2448264580
9 | 8 | 8 | 8 | 8 | 9 | SUM8 | 7 | 0 | ACEITO | OK | SIM | NAO | SIM | 1 | 101000 | -1 | 070800BEF913CB5C | 070800BEF913CB5C | CHECADO_ANTES_DA_COPIA | 2448352318 | 2448365580
10 | 9 | 9 | 9 | 9 | 10 | SUM8 | 7 | 0 | ACEITO | OK | SIM | NAO | SIM | 1 | 101000 | -1 | 0709009B85BA76A0 | 0709009B85BA76A0 | CHECADO_ANTES_DA_COPIA | 2448453318 | 2448466581
