enzogomes2006/esp32-deteccao-erros-telemetria/revisoes/corpo64/triagem/20261019_102351_826_CRC8_modo0_10/rx.csv

evento_id | seq_experimento | seq_rx | seq_referencia | seq_enlace_esperada | seq_enlace_proxima | tecnica | len_rx | residuo | decisao | status | payload_confere | cabecalho_diverge | entregue_aplicacao | verificacao_us | intervalo_inicio_us | recuperacao_ms | corpo_rx_hex | corpo_tx_hex | motivo | decisao_us | referencia_us
1 | 0 | 0 | 0 | 0 | 1 | CRC8 | 7 | 0 | ACEITO | OK | SIM | NAO | SIM | 3 | 0 | -1 | 070000B0E1A9F055 | 070000B0E1A9F055 | CHECADO_ANTES_DA_COPIA | 2564863320 | 2564876568
2 | 1 | 1 | 1 | 1 | 2 | CRC8 | 7 | 0 | ACEITO | OK | SIM | NAO | SIM | 3 | 101001 | -1 | 070100D1B7B57458 | 070100D1B7B57458 | CHECADO_ANTES_DA_COPIA | 2564964320 | 2564977568
3 | 2 | 2 | 2 | 2 | 3 | CRC8 | 7 | 0 | ACEITO | OK | SIM | NAO | SIM | 3 | 101000 | -1 | 070200DAEC9D8D86 | 070200DAEC9D8D86 | CHECADO_ANTES_DA_COPIA | 2565065320 | 2565078569
4 | 3 | 3 | 3 | 3 | 4 | CRC8 | 7 | 0 | ACEITO | OK | SIM | NAO | SIM | 3 | 101000 | -1 | 07030086CE8C78A9 | 07030086CE8C78A9 | CHECADO_ANTES_DA_COPIA | 2565166320 | 2565179570
5 | 4 | 4 | 4 | 4 | 5 | CRC8 | 7 | 0 | ACEITO | OK | SIM | NAO | SIM | 3 | 101000 | -1 | 070400C4DE6019FC | 070400C4DE6019FC | CHECADO_ANTES_DA_COPIA | 2565267320 | 2565280571
6 | 5 | 5 | 5 | 5 | 6 | CRC8 | 7 | 0 | ACEITO | OK | SIM | NAO | SIM | 3 | 101000 | -1 | 070500CD95D049E1 | 070500CD95D049E1 | CHECADO_ANTES_DA_COPIA | 2565368320 | 2565381571
7 | 6 | 6 | 6 | 6 | 7 | CRC8 | 7 | 0 | ACEITO | OK | SIM | NAO | SIM | 3 | 101000 | -1 | 070600D6DEAB324E | 070600D6DEAB324E | CHECADO_ANTES_DA_COPIA | 2565469320 | 2565482570
8 | 7 | 7 | 7 | 7 | 8 | CRC8 | 7 | 0 | ACEITO | OK | SIM | NAO | SIM | 3 | 101000 | -1 | 070700D7EFE2A9D5 | 070700D7EFE2A9D5 | CHECADO_ANTES_DA_COPIA | 2565570320 | 2565583570
9 | 8 | 8 | 8 | 8 | 9 | CRC8 | 7 | 0 | ACEITO | OK | SIM | NAO | SIM | 3 | 101000 | -1 | 0708008D982D1355 | 0708008D982D1355 | CHECADO_ANTES_DA_COPIA | 2565671320 | 2565684570
10 | 9 | 9 | 9 | 9 | 10 | CRC8 | 7 | 0 | ACEITO | OK | SIM | NAO | SIM | 3 | 101000 | -1 | 070900C1C38A3354 | 070900C1C38A3354 | CHECADO_ANTES_DA_COPIA | 2565772320 | 2565785571
