enzogomes2006/esp32-deteccao-erros-telemetria/pdfs_por_etapa/Parte_1_Tabelas_de_Resultados_ESP32.pdf

TELEMETRIA ESP32 | PARTE 1 - RESULTADOS | 1
PARTE 1 | EXPERIMENTOS DE TELEMETRIA ESP32

# Tabelas de resultados

Consolidação das sete rodadas de 1000 quadros, conforme os resumos dos monitores seriais apresentados na conversa. Cada linha das tabelas soma 1000 quadros.

### 1. SUM8 - soma modular de 8 bits

Modo de ruído | OK | Corrompidos | Perdidos | Não detectados | Taxa de não detecção
0 - desligado | 1000 | 0 | 0 | 0 | Não se aplica
1 - um bit | 478 | 522 | 0 | 0 | 0%
2 - dois bits | 236 | 757 | 0 | 7 | 0,9162%
3 - rajada | 46 | 954 | 0 | 0 | 0%

### 2. CRC8

Modo de ruído | OK | Corrompidos | Perdidos | Não detectados | Taxa de não detecção
1 - um bit | 488 | 512 | 0 | 0 | 0%
2 - dois bits | 260 | 740 | 0 | 0 | 0%
3 - rajada | 35 | 965 | 0 | 0 | 0%

### 3. Cálculo da taxa de não detecção

A taxa considera somente os quadros em que houve erro, e não o total de quadros enviados.

Taxa = não detectados / (corrompidos + não detectados)

SUM8, modo 2: 7 / (757 + 7) = 7 / 764 = 0,009162... ≈ 0,9162%.

No modo 0, não houve quadros com erro; por isso, a taxa não se aplica (denominador zero).

### Observação sobre a comparação

O ajuste do RUÍDO mudou antes da última rodada de CRC8 com rajada. Estas tabelas preservam os resultados obtidos; a comparação final ainda depende da verificação de condições equivalentes entre as técnicas.
