enzogomes2006/esp32-deteccao-erros-telemetria/(commit log)

2026-10-19 Entrega final: firmware ESP32, relatorio e sete coletas validadas
2026-10-19 Adiciona revisao CORPO64 para validacao fisica
2026-10-19 Documenta proximos passos de testes e entrega
2026-10-20 Organiza entrega atual e remove materiais de preparacao
2026-10-20 Simplifica entrega e documenta o controle dirigido de ruido
